yellobyte/YB-ESP32-S3-ETH/doc/YB-ESP32-S3-ETH_ArduinoIDE_Board-Selection.jpg

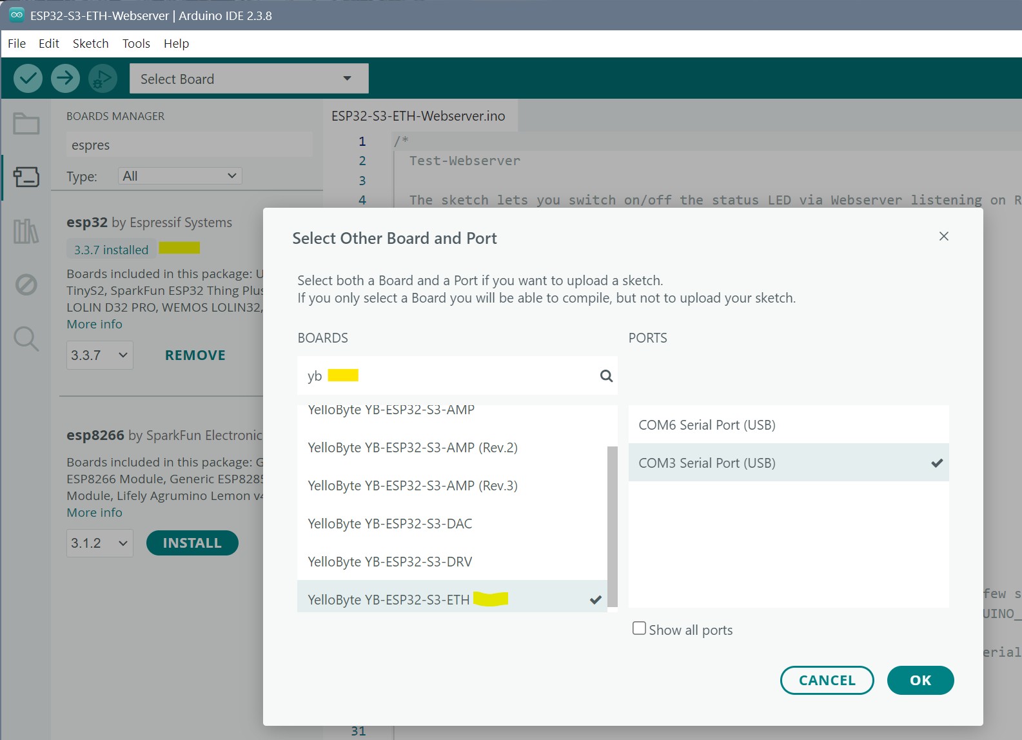
doc/YB-ESP32-S3-ETH_ArduinoIDE_Board-Selection.jpg
