yellobyte/YB-ESP32-S3-ETH/doc/YB-ESP32-S3-ETH_block_diagram.jpg

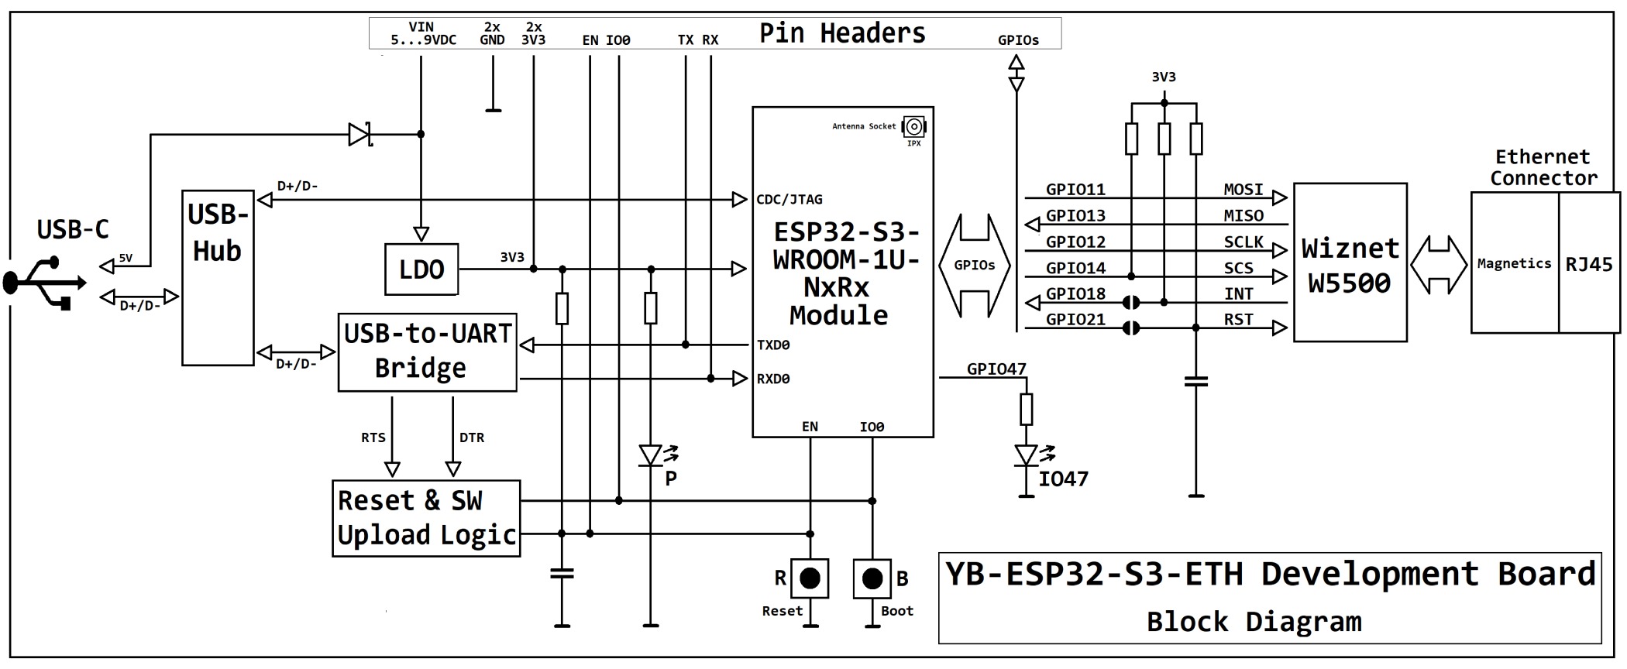
doc/YB-ESP32-S3-ETH_block_diagram.jpg
