yellobyte/YB-ESP32-S3-ETH/doc/YB-ESP32-S3-ETH_board_bottom.jpg

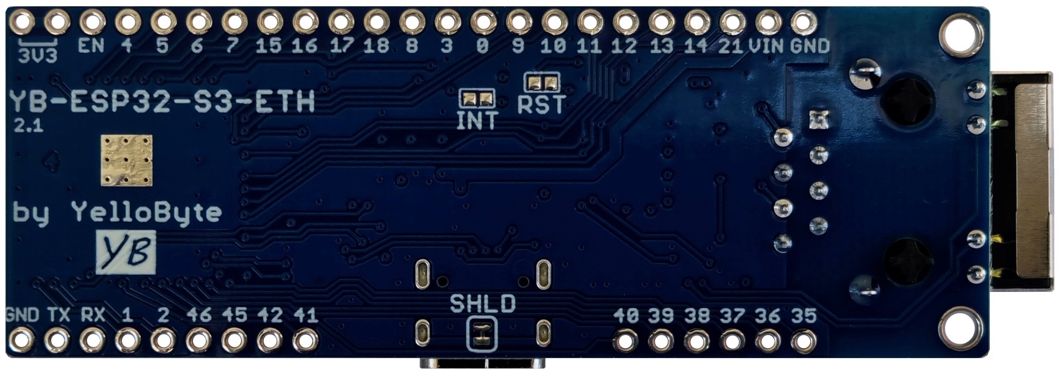
doc/YB-ESP32-S3-ETH_board_bottom.jpg
