yellobyte/YB-ESP32-S3-ETH/doc/YB-ESP32-S3-ETH_on_breadboard.jpg

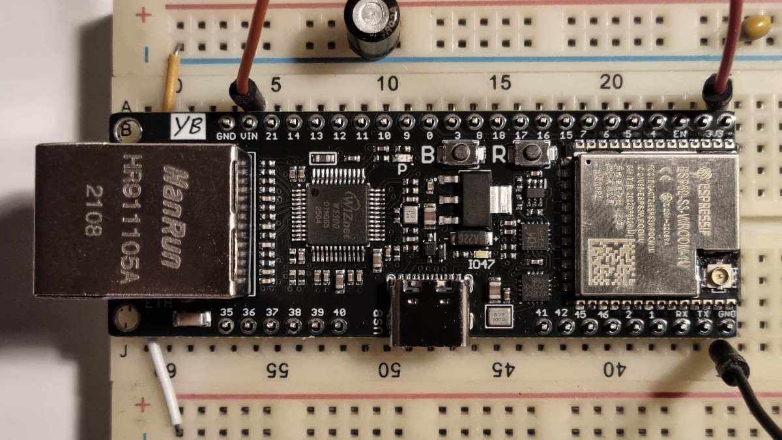
doc/YB-ESP32-S3-ETH_on_breadboard.jpg
