yellobyte/YB-ESP32-S3-ETH/doc/YB-ESP32-S3-ETH_outline.jpg

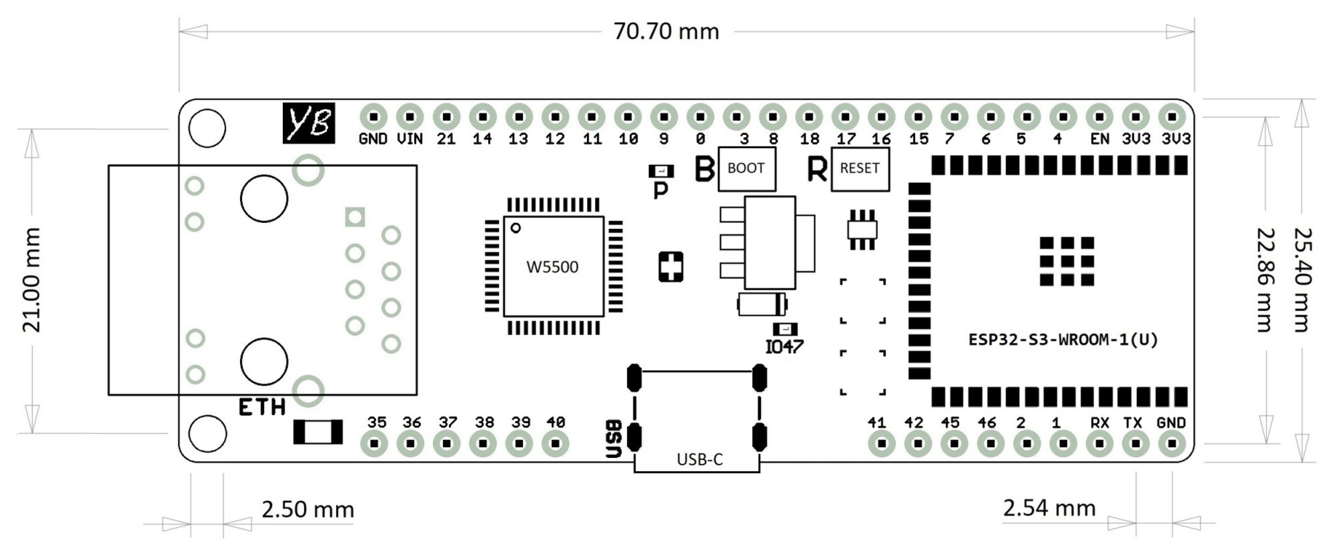
doc/YB-ESP32-S3-ETH_outline.jpg
