yellobyte/YB-ESP32-S3-ETH/doc/YB-ESP32-S3-ETH_Schematic_1-2.jpg

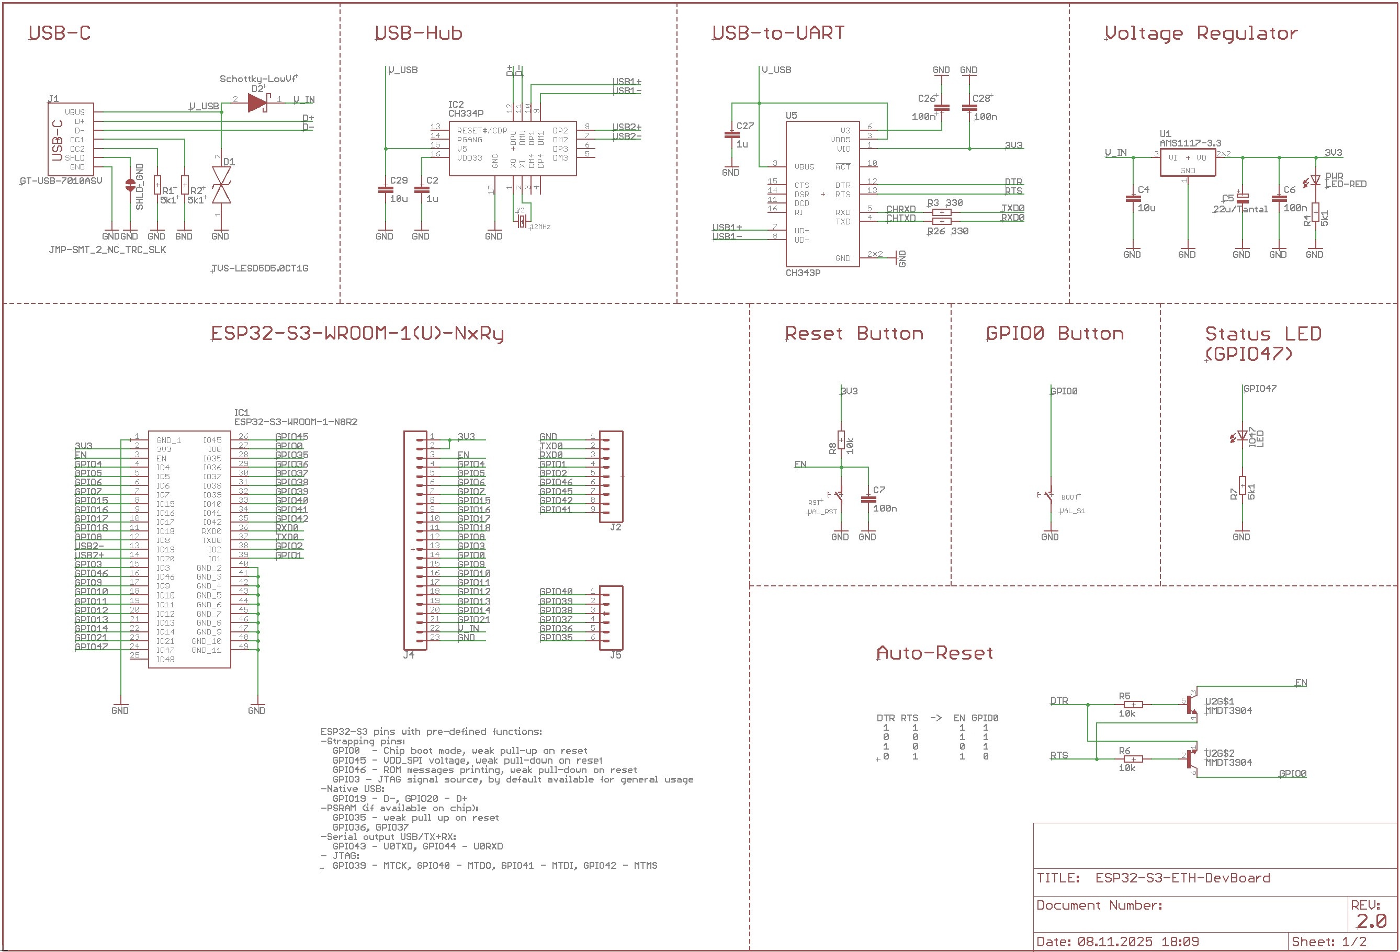
doc/YB-ESP32-S3-ETH_Schematic_1-2.jpg
