yellobyte/YB-ESP32-S3-ETH/doc/YB-ESP32-S3-ETH_Schematic_2-2.jpg

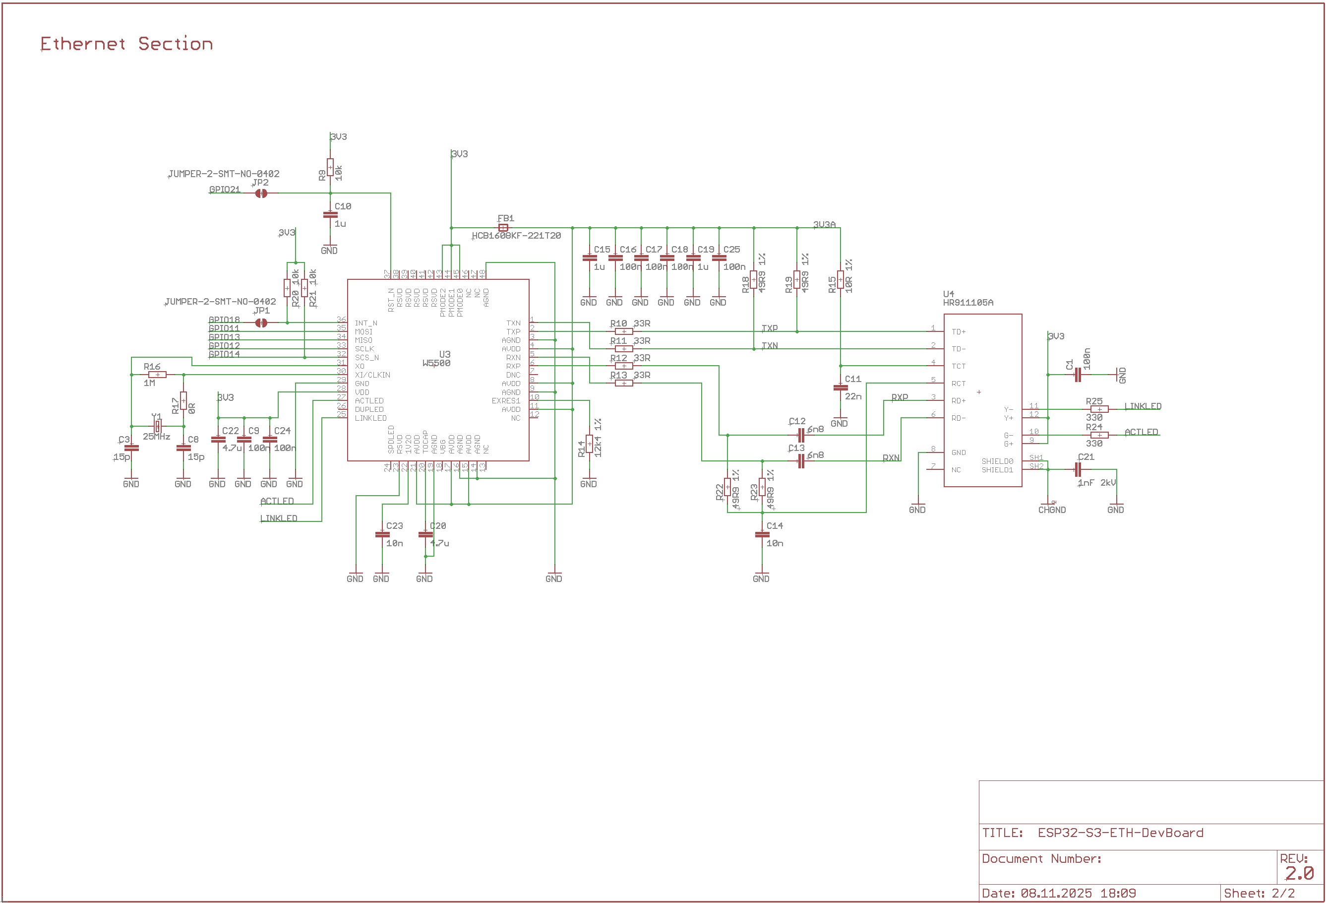
doc/YB-ESP32-S3-ETH_Schematic_2-2.jpg
