yellobyte/YB-ESP32-S3-ETH/(commit log)

2025-12-03 board updates
2025-12-03 board update
